LesKaribous/Karibous-2026-PAMI-Ninja/README.md

# Karibous-2026-PAMI-Ninja
PAMI Ninja - Coupe de France de robotique 2026
