LesKaribous/Karibous-2026-PAMI-Ninja/DESIGN/path2.png

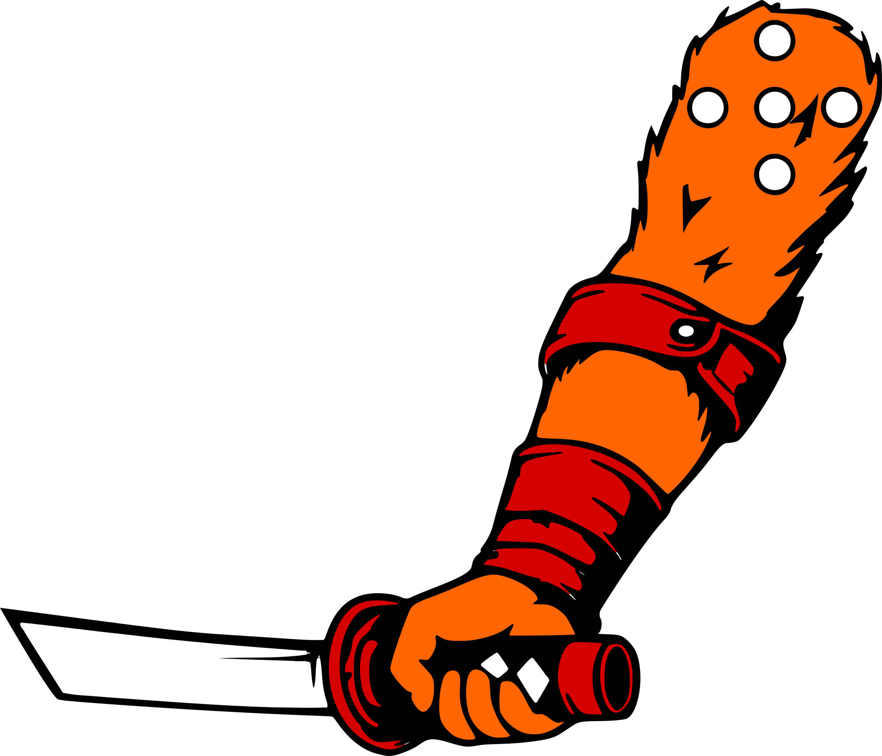
DESIGN/path2.png
