LesKaribous/Karibous-2026-PAMI-Ninja/MCAD/Import/pump-assembled.FCStd

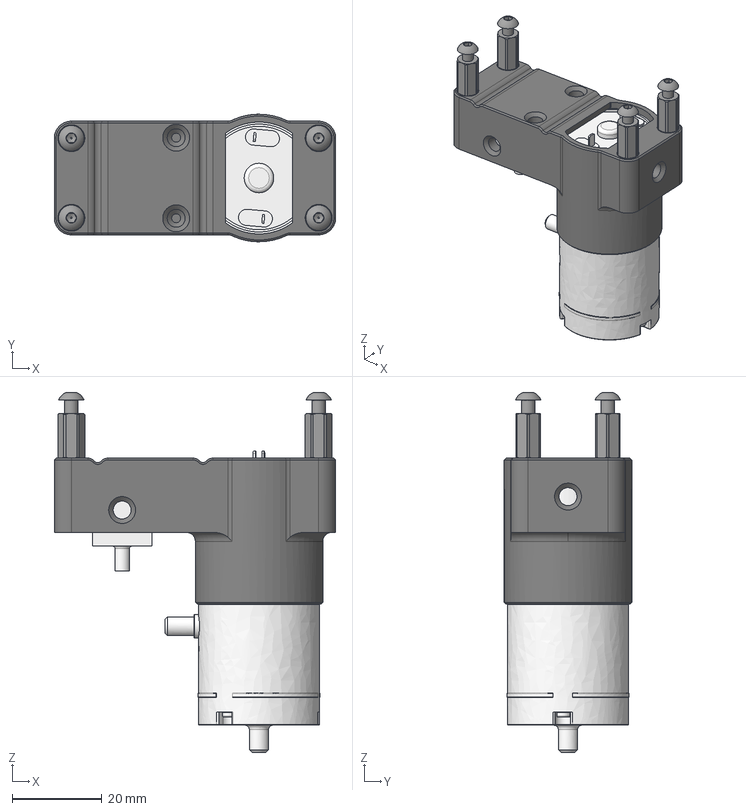
[picture p2: CAD file, 2026-01-25]
MCAD/Import/pump-assembled.FCStd
62.9 x 28.5 x 80.4 mm
SupportPompe x 2
M3x5.5x10-Spacer005
M3x5.5x10-Spacer006
M3x5.5x10-Spacer001
M3x5.5x10-Spacer
M3x6-Screw010
M3x6-Screw009
M3x6-Screw008
M3x6-Screw
