LesKaribous/Karibous-2026-PAMI-Ninja/DESIGN/arm-ninja-solo.3mf

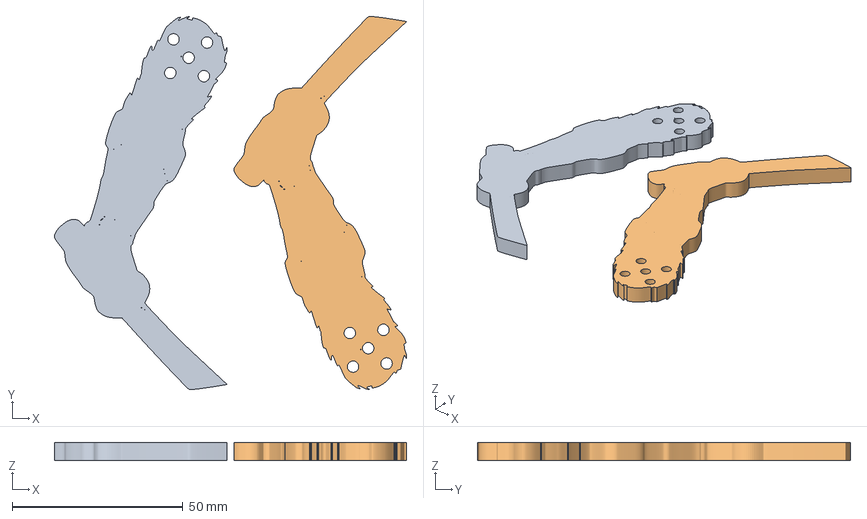
[picture p3: CAD file, 2026-03-20]
DESIGN/arm-ninja-solo.3mf
103.3 x 109.3 x 5.41 mm
Assembly x 2
