LesKaribous/Karibous-2026-PAMI-Ninja/ECAD/PumpBoard-2026/models/MICRO-POMPE 370 v2.step

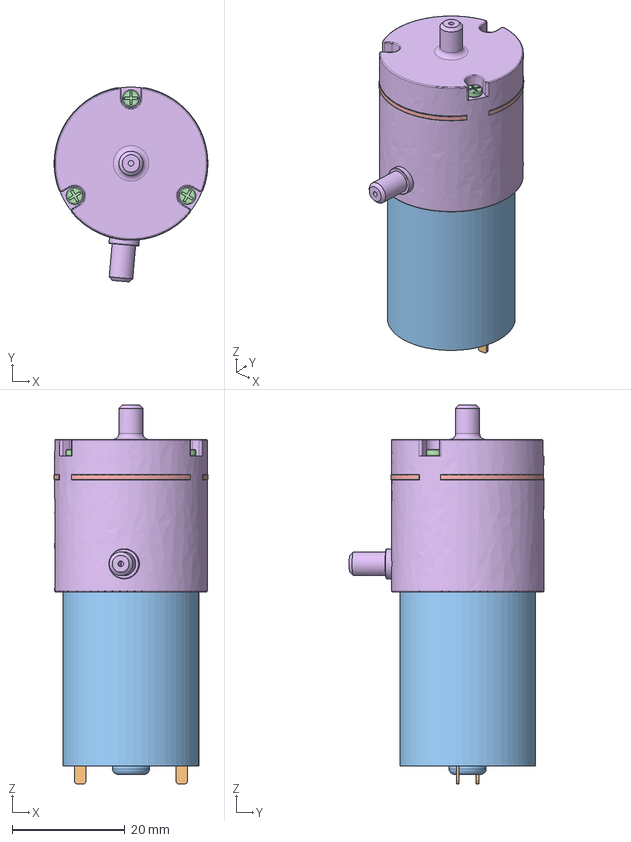
[picture p4: CAD file, 2026-01-25]
ECAD/PumpBoard-2026/models/MICRO-POMPE 370 v2.step
27.3 x 34.6 x 67.3 mm
