LesKaribous/Karibous-2026-PAMI-Ninja/ECAD/PumpBoard-2026/PumpBoard-2026.step

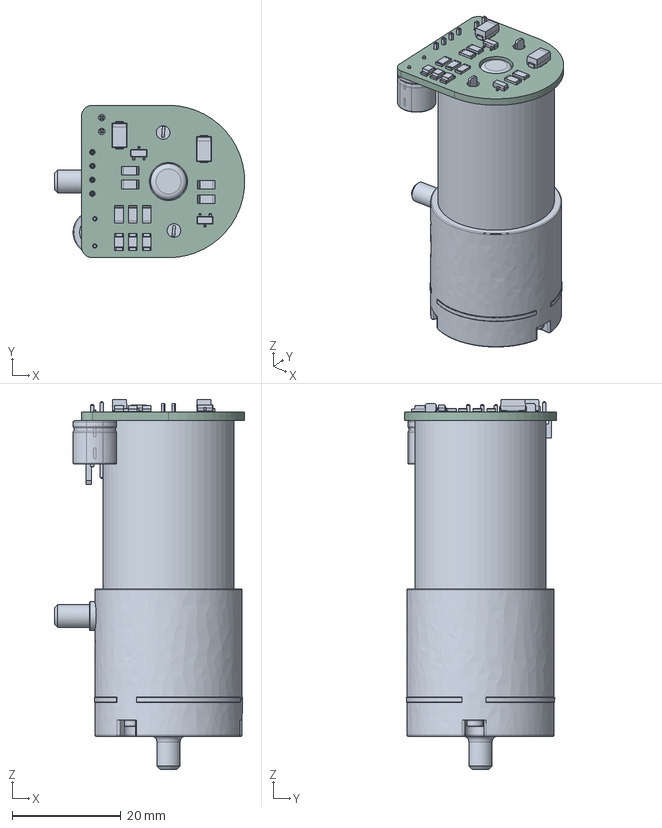
[picture p5: CAD file, 2026-01-25]
ECAD/PumpBoard-2026/PumpBoard-2026.step
35.0 x 28.0 x 68.0 mm
R_1206_3216Metric x 7
D_SMA x 2
LED_1206_3216Metric x 3
SOT-23 x 2
CP_Radial_D8.0mm_P5.00mm
MICRO-POMPE 370 v2
Molex_KK-254_AE-6410-02A_1x02_P2.54mm_Vertical
PinHeader_1x04_P2.54mm_Vertical
PumpBoard-2026_PCB
