LesKaribous/Karibous-2026-PAMI-Ninja/MCAD/Import/BAU.step

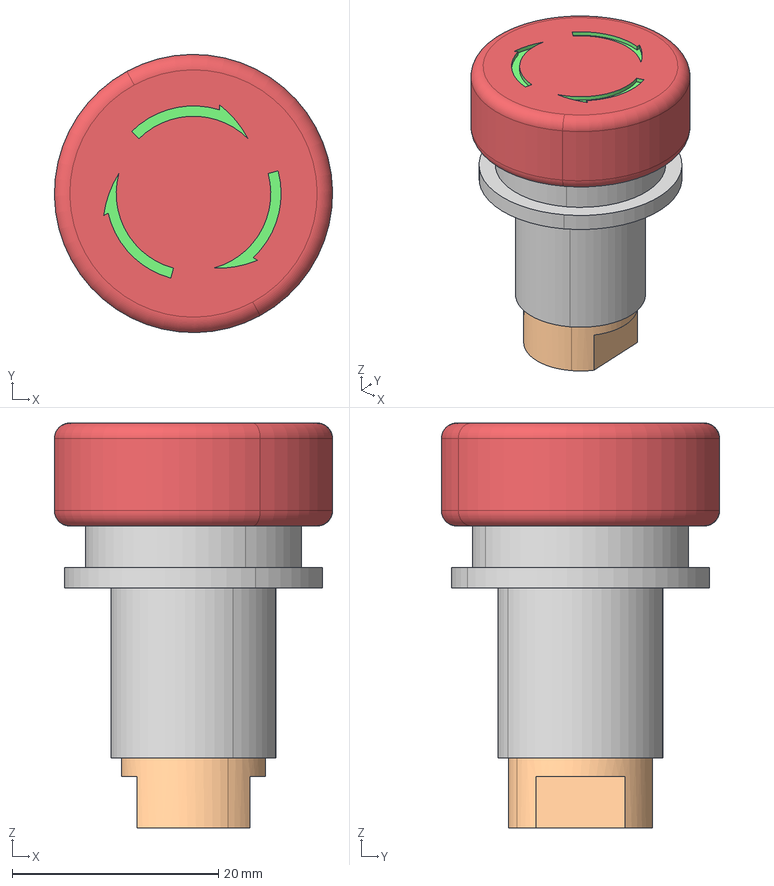
[picture p6: CAD file, 2026-01-25]
MCAD/Import/BAU.step
27.0 x 27.0 x 39.3 mm
