LesKaribous/Karibous-2026-PAMI-Ninja/MCAD/ProtoNINJA-Components.step

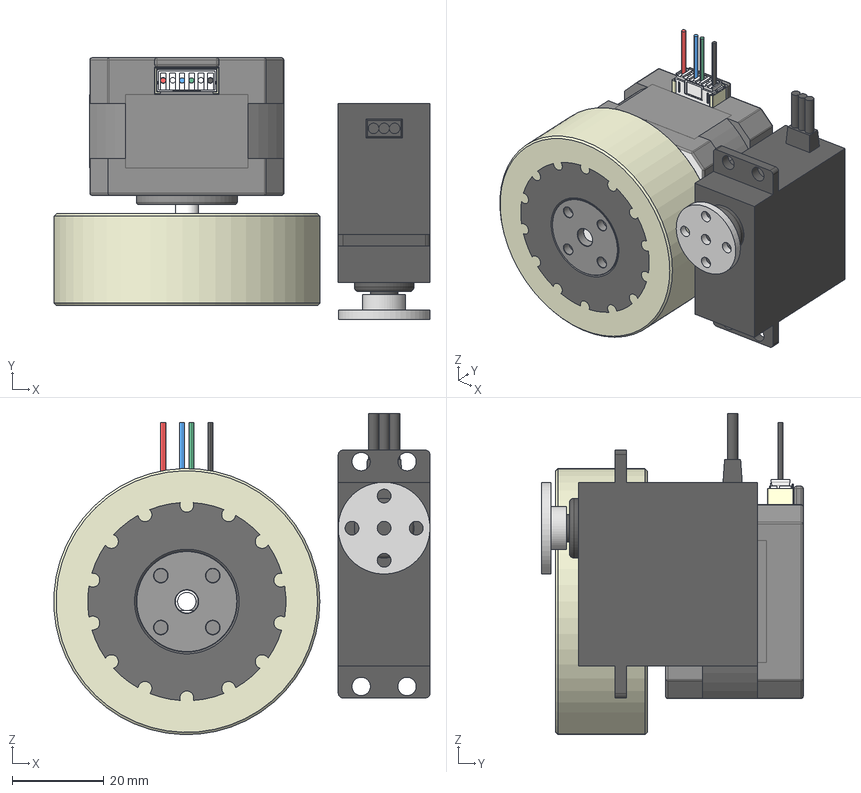
[picture p7: CAD file, 2026-05-08]
MCAD/ProtoNINJA-Components.step
81.9 x 57.0 x 70.0 mm
ServoBody001
ServoAxis001
RoundServoHorn001
Tire
Hub-ID-5mm-OD-22mm
CoreWheel0
17HE12-1204S
