LesKaribous/Karibous-2026-PAMI-Ninja/ECAD/PumpBoard-2026/models/miniEV.step

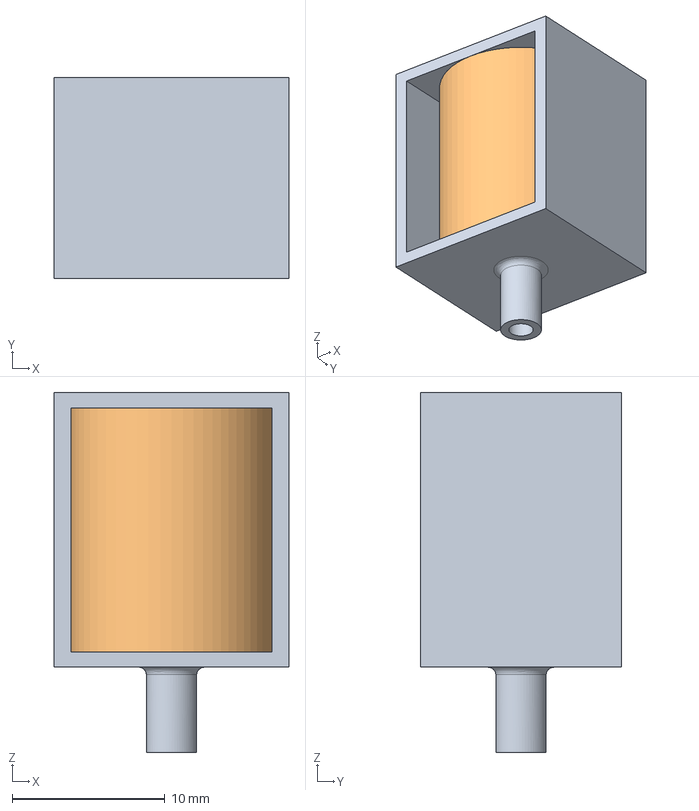
[picture p8: CAD file, 2026-01-25]
ECAD/PumpBoard-2026/models/miniEV.step
15.4 x 13.2 x 23.6 mm
