LesKaribous/Karibous-2026-PAMI-Ninja/MCAD/Import/CanonLPE6-Canon.step

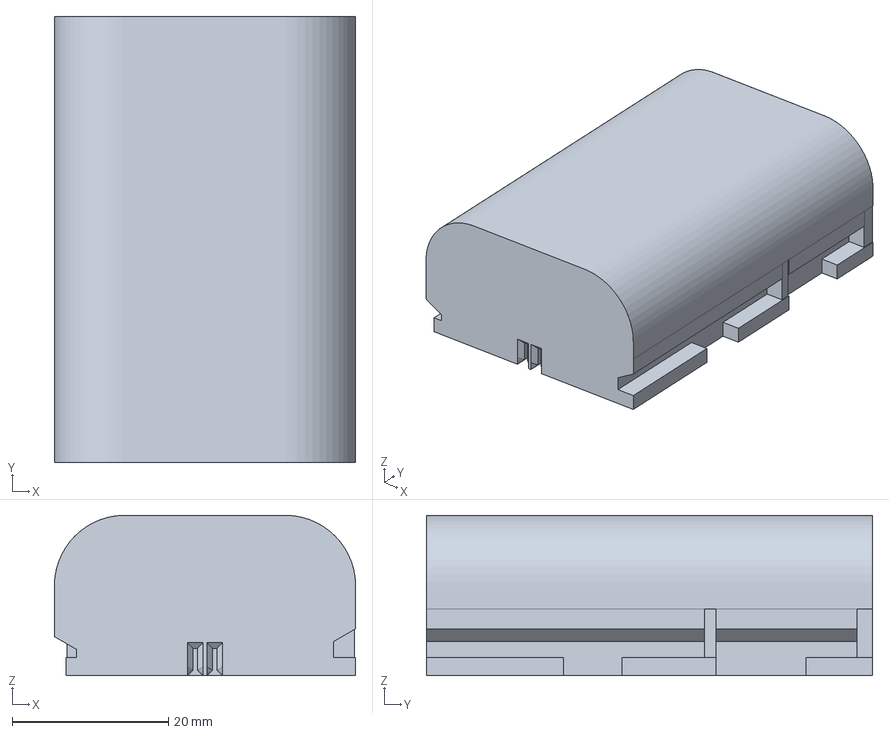
[picture p9: CAD file, 2026-01-25]
MCAD/Import/CanonLPE6-Canon.step
38.5 x 57.0 x 20.5 mm
