LesKaribous/Karibous-2026-PAMI-Ninja/MCAD/PAMI_NINJA.FCStd

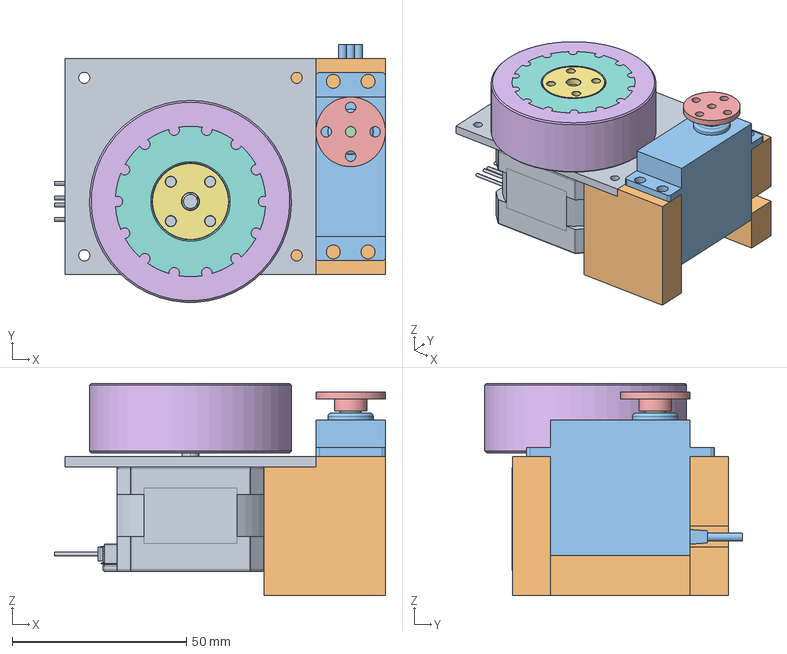
[picture p10: CAD file, 2026-05-08]
MCAD/PAMI_NINJA.FCStd
95.1 x 73.9 x 61.0 mm
Motor_Plate
Chassis
ServoBody001
ServoAxis001
RoundServoHorn001
Tire
Hub-ID-5mm-OD-22mm
CoreWheel0
17HE12-1204S
