LesKaribous/Karibous-2026-PAMI-Ninja/MCAD/PAMI_NINJA_DUMB_PUSHER.FCStd

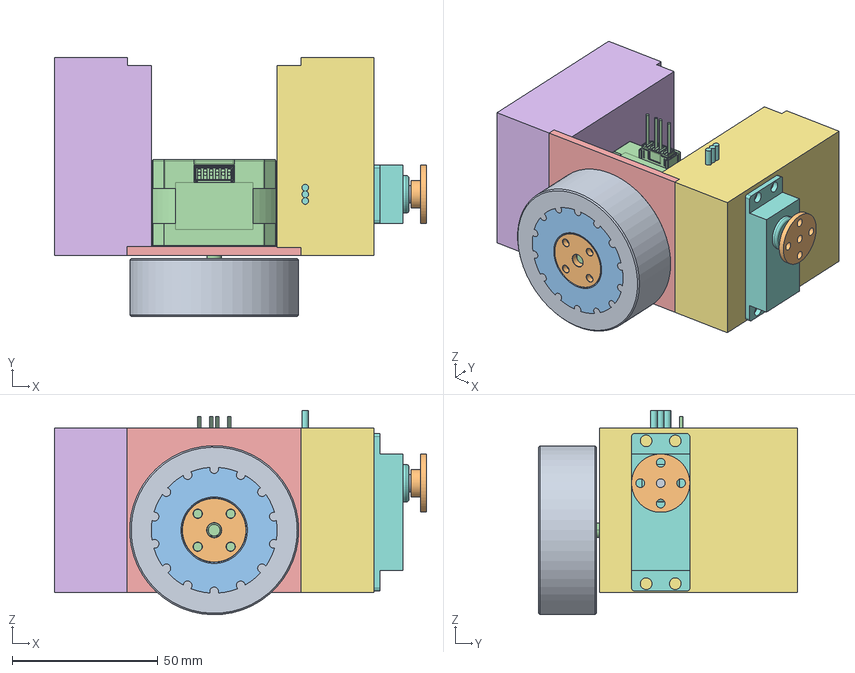
[picture p11: CAD file, 2026-05-08]
MCAD/PAMI_NINJA_DUMB_PUSHER.FCStd
127.7 x 89.0 x 70.1 mm
Tire
Hub-ID-5mm-OD-22mm
CoreWheel0
17HE12-1204S
MotorPlate
Chassis
ServoBody001
ServoAxis001
RoundServoHorn001
