LesKaribous/Karibous-2026-PAMI-Ninja/MCAD/Import/GENERIC-370_vaccum-pump-12V-4Lmin.STEP

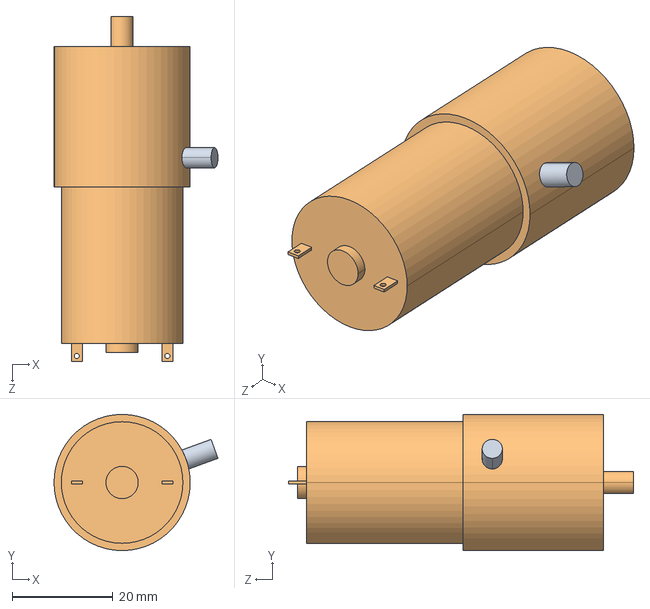
[picture p12: CAD file, 2026-01-25]
MCAD/Import/GENERIC-370_vaccum-pump-12V-4Lmin.STEP
32.5 x 27.0 x 68.4 mm
