LesKaribous/Karibous-2026-PAMI-Ninja/MCAD/ProtoNINJA.FCStd

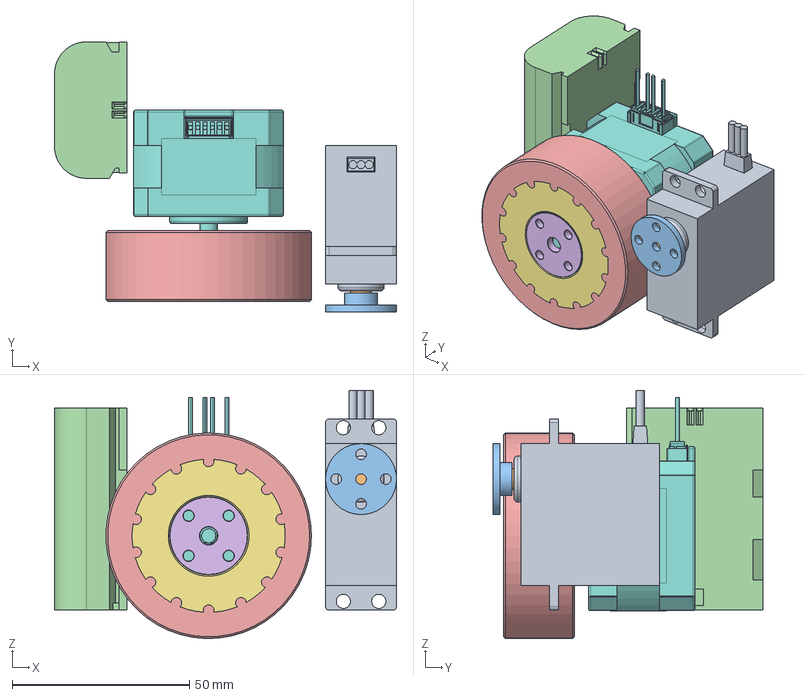
[picture p13: CAD file, 2026-05-08]
MCAD/ProtoNINJA.FCStd
96.5 x 76.2 x 70.0 mm
ServoBody001
ServoAxis001
RoundServoHorn001
CanonLPE6-Canon
Tire
Hub-ID-5mm-OD-22mm
CoreWheel0
17HE12-1204S
