LesKaribous/Karibous-2026-PAMI-Ninja/MCAD/Import/Gh-S37D Servo.STEP

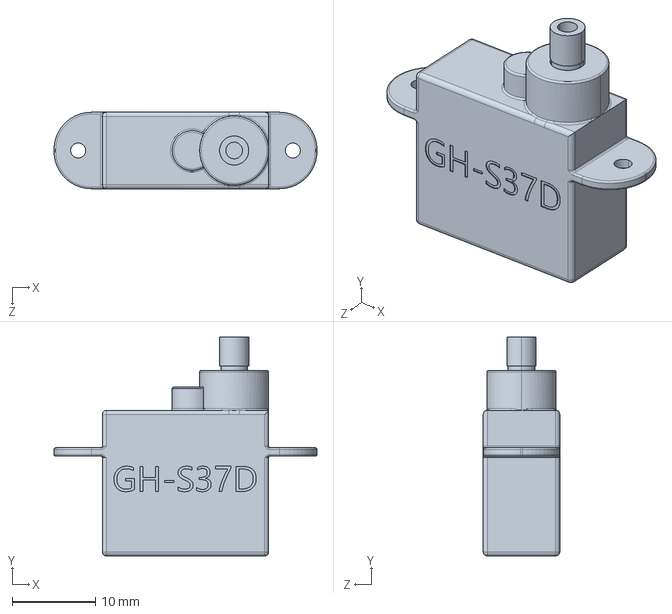
[picture p14: CAD file, 2026-01-25]
MCAD/Import/Gh-S37D Servo.STEP
31.6 x 26.3 x 9.20 mm
