LesKaribous/Karibous-2026-PAMI-Ninja/MCAD/Import/28BYJ-48_Stepper.STEP

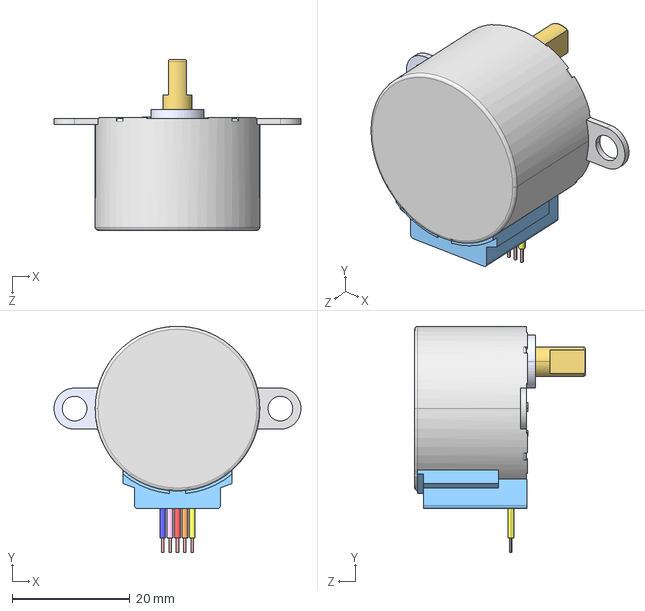
[picture p15: CAD file, 2026-01-25]
MCAD/Import/28BYJ-48_Stepper.STEP
42.0 x 38.5 x 29.0 mm
