LesKaribous/Karibous-2026-PAMI-Ninja/MCAD/Import/17HE12-1204S.STEP

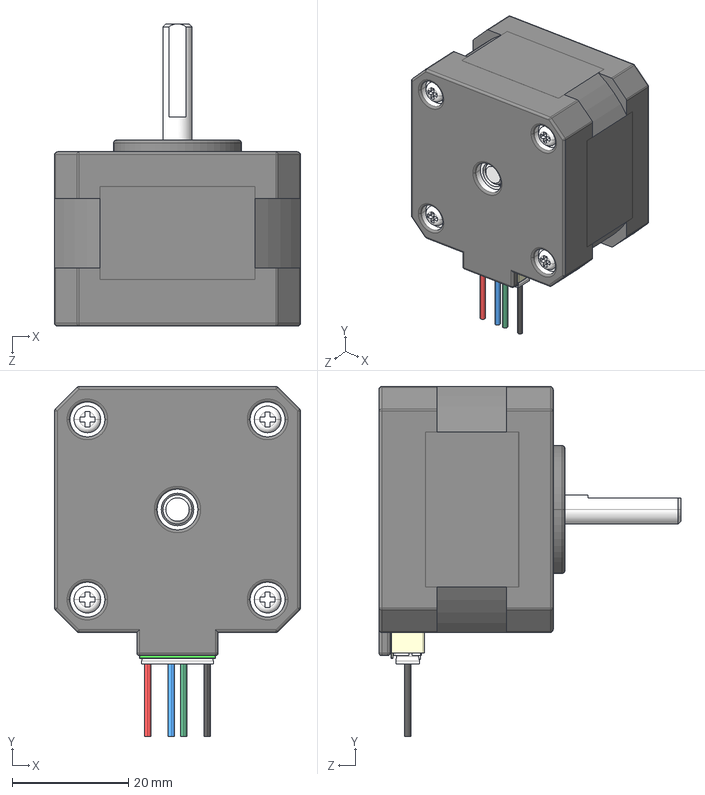
[picture p16: CAD file, 2026-01-25]
MCAD/Import/17HE12-1204S.STEP
42.3 x 60.2 x 52.0 mm
