LesKaribous/Karibous-2026-PAMI-Ninja/MCAD/Import/17HE15-1504S.STEP

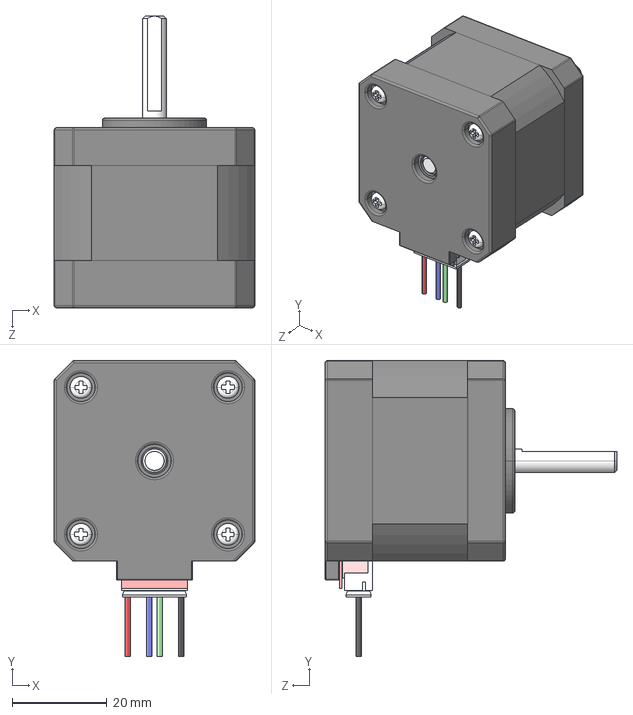
[picture p17: CAD file, 2026-01-25]
MCAD/Import/17HE15-1504S.STEP
42.3 x 62.4 x 61.5 mm
