LesKaribous/Karibous-2026-PAMI-Ninja/(list of files, cad)

Other CAD files:
ECAD/PumpBoard-2026/PumpBoard-2026.FCStd
