LesKaribous/Karibous-2026-PAMI-Ninja/ECAD/NinjaPAMI-2026/NinjaPAMI-2026.kicad_pcb

## KiCad design ECAD/NinjaPAMI-2026/NinjaPAMI-2026.kicad_pcb (2026-03-20)

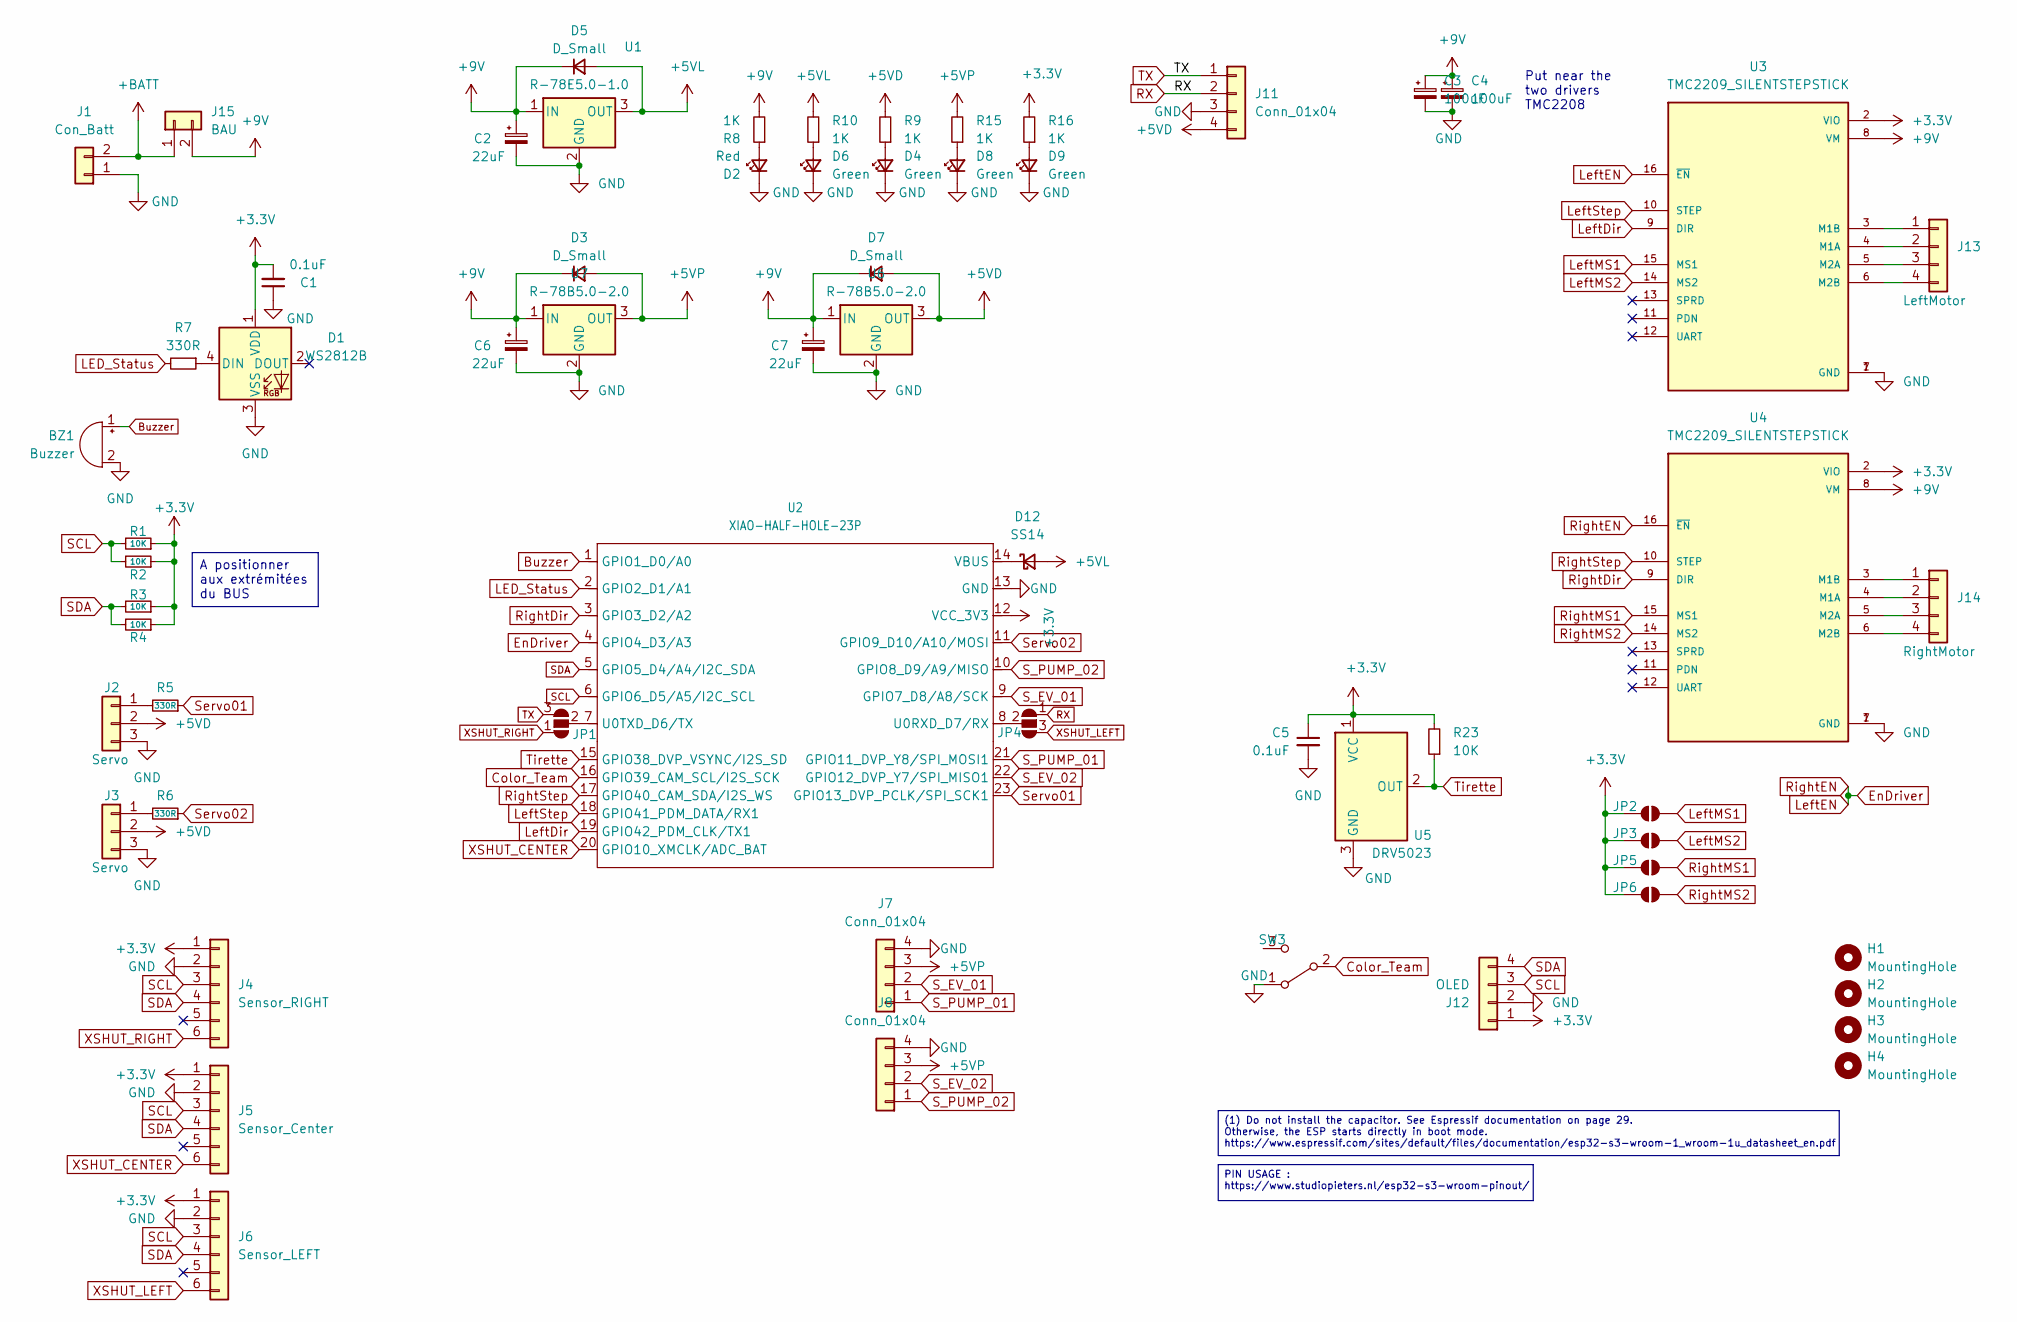
[picture p18: schematic NinjaPAMI-2026.kicad_sch]

Parts:
BZ1: Buzzer; Buzzer_12x9.5RM7.6
C1: 0.1uF; C_1206_3216Metric
C2, C6, C7: 22uF; CP_Elec_5x5.4
C3, C4: 100uF; CP_Radial_D8.0mm_P3.50mm
C5: 0.1uF; C_1206_3216Metric_Pad1.33x1.80mm_HandSolder
D1: WS2812B; LED_WS2812B_PLCC4_5.0x5.0mm_P3.2mm
D2: Red; LED_1206_3216Metric
D3, D5, D7: D_Small; D_SMA_Handsoldering
D4, D6, D8, D9: Green; LED_1206_3216Metric
D12: SS14; D_SMA_Handsoldering
H1, H2, H3, H4: MountingHole; MountingHole_3.2mm_M3
J1: Con_Batt; Molex_KK-254_AE-6410-02A_1x02_P2.54mm_Vertical
J2, J3: Servo; PinHeader_1x03_P2.54mm_Vertical
J4: Sensor_RIGHT; Molex_KK-254_AE-6410-06A_1x06_P2.54mm_Vertical
J5: Sensor_Center; Molex_KK-254_AE-6410-06A_1x06_P2.54mm_Vertical
J6: Sensor_LEFT; Molex_KK-254_AE-6410-06A_1x06_P2.54mm_Vertical
J7, J8, J11: Conn_01x04; Molex_KK-254_AE-6410-04A_1x04_P2.54mm_Vertical
J12: OLED; Molex_KK-254_AE-6410-04A_1x04_P2.54mm_Vertical
J13: LeftMotor; Molex_KK-254_AE-6410-04A_1x04_P2.54mm_Vertical
J14: RightMotor; Molex_KK-254_AE-6410-04A_1x04_P2.54mm_Vertical
J15: BAU; Molex_KK-254_AE-6410-02A_1x02_P2.54mm_Vertical
JP1, JP4: SolderJumper_3_Open; SolderJumper-3_P1.3mm_Open_RoundedPad1.0x1.5mm_NumberLabels
JP2, JP3, JP5, JP6: SolderJumper_2_Open; SolderJumper-2_P1.3mm_Open_RoundedPad1.0x1.5mm
R1, R2, R3, R4, R23: 10K; R_1206_3216Metric_Pad1.30x1.75mm_HandSolder
R5, R6, R7: 330R; R_1206_3216Metric_Pad1.30x1.75mm_HandSolder
R8, R9, R10, R15, R16: 1K; R_1206_3216Metric_Pad1.30x1.75mm_HandSolder
SW3: SW_SPDT; SK-12D10 1P2T
U1: R-78E5.0-1.0; Converter_DCDC_RECOM_R-78E-0.5_THT
U2: XIAO-HALF-HOLE-23P; MOUDLE23P-SMD-2.54-21X17.8MM.kicad_mod.kicad_sym
U3, U4: TMC2209_SILENTSTEPSTICK; MODULE_TMC2209_SILENTSTEPSTICK; PARTREV 1.20
U5: DRV5023; SOT-23_Handsoldering
U6, U7: R-78B5.0-2.0; Converter_DCDC_RECOM_R-78B-2.0_THT

Connections:
+3.3V: C1.2, C5.1, D1.1 (VDD), J4.1, J5.1, J6.1, J12.1, JP2.1 (A), JP3.1 (A), JP5.1 (A), JP6.1 (A), R1.1, R2.1, R3.1, R4.1, R16.2, R23.2, U2.12 (VCC_3V3), U3.2 (VIO), U4.2 (VIO), U5.1 (VCC)
+5VD: D7.2 (A), J2.2, J3.2, J11.4, R9.2, U6.3 (OUT)
+5VL: D5.2 (A), D12.2 (A), R10.2, U1.3 (OUT)
+5VP: D3.2 (A), J7.3, J8.3, R15.2, U7.3 (OUT)
+9V: C2.1, C3.1, C4.1, C6.1, C7.1, D3.1 (K), D5.1 (K), D7.1 (K), J15.2, R8.2, U1.1 (IN), U3.8 (VM), U4.8 (VM), U6.1 (IN), U7.1 (IN)
+BATT: J1.2, J15.1
Buzzer: BZ1.1 (+), U2.1 (GPIO1_D0/A0)
Color_Team: SW3.2 (B), U2.16 (GPIO39_CAM_SCL/I2S_SCK)
EnDriver: U2.4 (GPIO4_D3/A3), U3.16 (~EN), U4.16 (~EN)
GND: BZ1.2 (-), C1.1, C2.2, C3.2, C4.2, C5.2, C6.2, C7.2, D1.3 (VSS), D2.1 (K), D4.1 (K), D6.1 (K), D8.1 (K), D9.1 (K), J1.1, J2.3, J3.3, J4.2, J5.2, J6.2, J7.4, J8.4, J11.3, J12.2, SW3.1 (A), U1.2 (GND), U2.13 (GND), U3.1 (GND), U3.7 (GND), U4.1 (GND), U4.7 (GND), U5.3 (GND), U6.2 (GND), U7.2 (GND)
LED_Status: R7.2, U2.2 (GPIO2_D1/A1)
LeftDir: U2.19 (GPIO42_PDM_CLK/TX1), U3.9 (DIR)
LeftMS1: JP2.2 (B), U3.15 (MS1)
LeftMS2: JP3.2 (B), U3.14 (MS2)
LeftStep: U2.18 (GPIO41_PDM_DATA/RX1), U3.10 (STEP)
unnamed: D1.4 (DIN), R7.1
unnamed: D2.2 (A), R8.1
unnamed: D4.2 (A), R9.1
unnamed: D6.2 (A), R10.1
unnamed: D8.2 (A), R15.1
unnamed: D9.2 (A), R16.1
unnamed: D12.1 (K), U2.14 (VBUS)
unnamed: J2.1, R5.2
unnamed: J3.1, R6.2
unnamed: J13.1, U3.3 (M1B)
unnamed: J13.2, U3.4 (M1A)
unnamed: J13.3, U3.5 (M2A)
unnamed: J13.4, U3.6 (M2B)
unnamed: J14.1, U4.3 (M1B)
unnamed: J14.2, U4.4 (M1A)
unnamed: J14.3, U4.5 (M2A)
unnamed: J14.4, U4.6 (M2B)
unnamed: JP1.2 (C), U2.7 (U0TXD_D6/TX)
unnamed: JP4.2 (C), U2.8 (U0RXD_D7/RX)
RX: J11.2, JP4.1 (A)
RightDir: U2.3 (GPIO3_D2/A2), U4.9 (DIR)
RightMS1: JP5.2 (B), U4.15 (MS1)
RightMS2: JP6.2 (B), U4.14 (MS2)
RightStep: U2.17 (GPIO40_CAM_SDA/I2S_WS), U4.10 (STEP)
SCL: J4.3, J5.3, J6.3, J12.3, R1.2, R2.2, U2.6 (GPIO6_D5/A5/I2C_SCL)
SDA: J4.4, J5.4, J6.4, J12.4, R3.2, R4.2, U2.5 (GPIO5_D4/A4/I2C_SDA)
S_EV_01: J7.2, U2.9 (GPIO7_D8/A8/SCK)
S_EV_02: J8.2, U2.22 (GPIO12_DVP_Y7/SPI_MISO1)
S_PUMP_01: J7.1, U2.21 (GPIO11_DVP_Y8/SPI_MOSI1)
S_PUMP_02: J8.1, U2.10 (GPIO8_D9/A9/MISO)
Servo01: R5.1, U2.23 (GPIO13_DVP_PCLK/SPI_SCK1)
Servo02: R6.1, U2.11 (GPIO9_D10/A10/MOSI)
TX: J11.1, JP1.3 (B)
Tirette: R23.1, U2.15 (GPIO38_DVP_VSYNC/I2S_SD), U5.2 (OUT)
XSHUT_CENTER: J5.6, U2.20 (GPIO10_XMCLK/ADC_BAT)
XSHUT_LEFT: J6.6, JP4.3 (B)
XSHUT_RIGHT: J4.6, JP1.1 (A)

Notes on the sheet:
Put near the two drivers TMC2208
PIN USAGE : https://www.studiopieters.nl/esp32-s3-wroom-pinout/
A positionner aux extrémitées du BUS
(1) Do not install the capacitor. See Espressif documentation on page 29. Otherwise, the ESP starts directly in boot mode. https://www.espressif.com/sites/default/files/documentation/esp32-s3-wroom-1_wroom-1u_datasheet_en.pdf

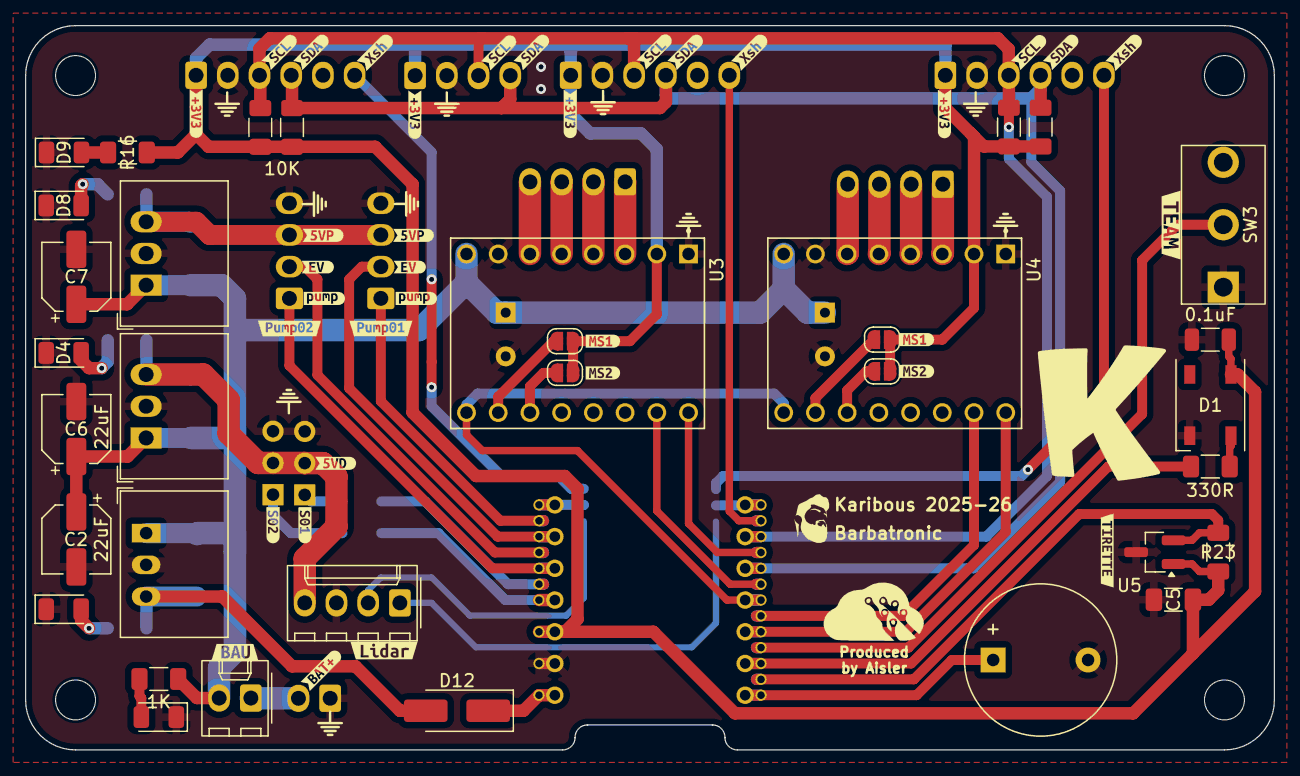
[picture p19: board NinjaPAMI-2026.kicad_pcb from above]

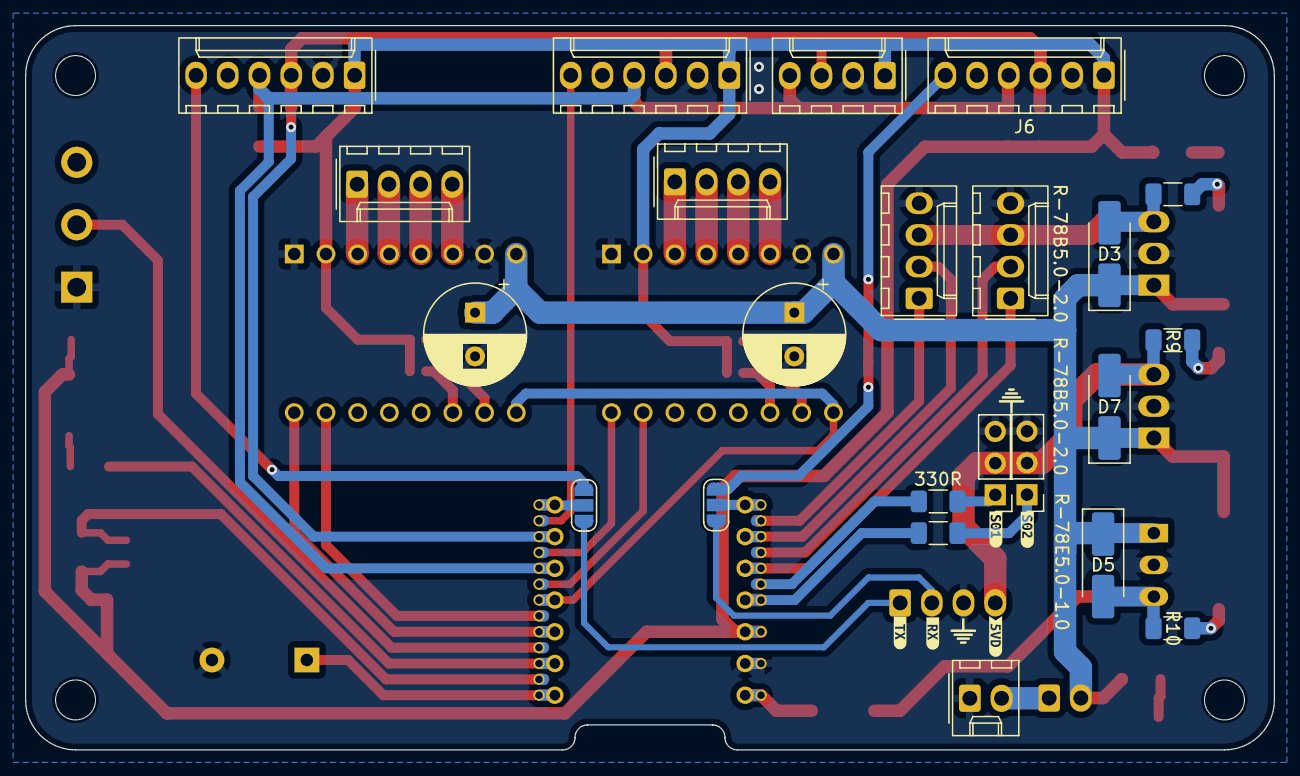
[picture p20: board NinjaPAMI-2026.kicad_pcb from below]

Board: 2 copper layers, 100.0 x 58.0 mm, 102 parts (28 on the bottom side), 52 nets.

Other parts of the board:
kibuzzard-670C04A5, kibuzzard-670C04A5#2, kibuzzard-670C04A5#3, kibuzzard-670C04A5#4: G***; kibuzzard-670C04A5
kibuzzard-670C07A3: G***; kibuzzard-670C07A3
kibuzzard-670C23C9: G***; kibuzzard-670C23C9
kibuzzard-670C047F: G***; kibuzzard-670C047F
kibuzzard-670C0507: G***; kibuzzard-670C0507
kibuzzard-670C0798: G***; kibuzzard-670C0798
kibuzzard-6998F5BE: G***; kibuzzard-6998F5BE
kibuzzard-6998F5D7: G***; kibuzzard-6998F5D7
kibuzzard-6998F8A6, kibuzzard-6998F8A6#2: G***; kibuzzard-6998F8A6
kibuzzard-6998F8DE: G***; kibuzzard-6998F8DE
kibuzzard-6998F8EA: G***; kibuzzard-6998F8EA
kibuzzard-6998F9AD, kibuzzard-6998F9AD#2: G***; kibuzzard-6998F9AD
kibuzzard-6998F92F, kibuzzard-6998F92F#2: G***; kibuzzard-6998F92F
kibuzzard-6998F94E, kibuzzard-6998F94E#2: G***; kibuzzard-6998F94E
kibuzzard-6998F900, kibuzzard-6998F900#2: G***; kibuzzard-6998F900
kibuzzard-6998F954, kibuzzard-6998F954#2: G***; kibuzzard-6998F954
kibuzzard-6998FA9D, kibuzzard-6998FA9D#2, kibuzzard-6998FA9D#3, kibuzzard-6998FA9D#4: G***; kibuzzard-6998FA9D
kibuzzard-6998FAED, kibuzzard-6998FAED#2, kibuzzard-6998FAED#3, kibuzzard-6998FAED#4: G***; kibuzzard-6998FAED
kibuzzard-6998FB46, kibuzzard-6998FB46#2, kibuzzard-6998FB46#3: G***; kibuzzard-6998FB46
kibuzzard-6998FE5D, kibuzzard-6998FE5D#2: G***; kibuzzard-6998FE5D
kibuzzard-6998FE66, kibuzzard-6998FE66#2: G***; kibuzzard-6998FE66
