LesKaribous/Karibous-2026-PAMI-Ninja/ECAD/PumpBoard-2026/PumpBoard-2026.kicad_pcb

## KiCad design ECAD/PumpBoard-2026/PumpBoard-2026.kicad_pcb (2026-02-20)

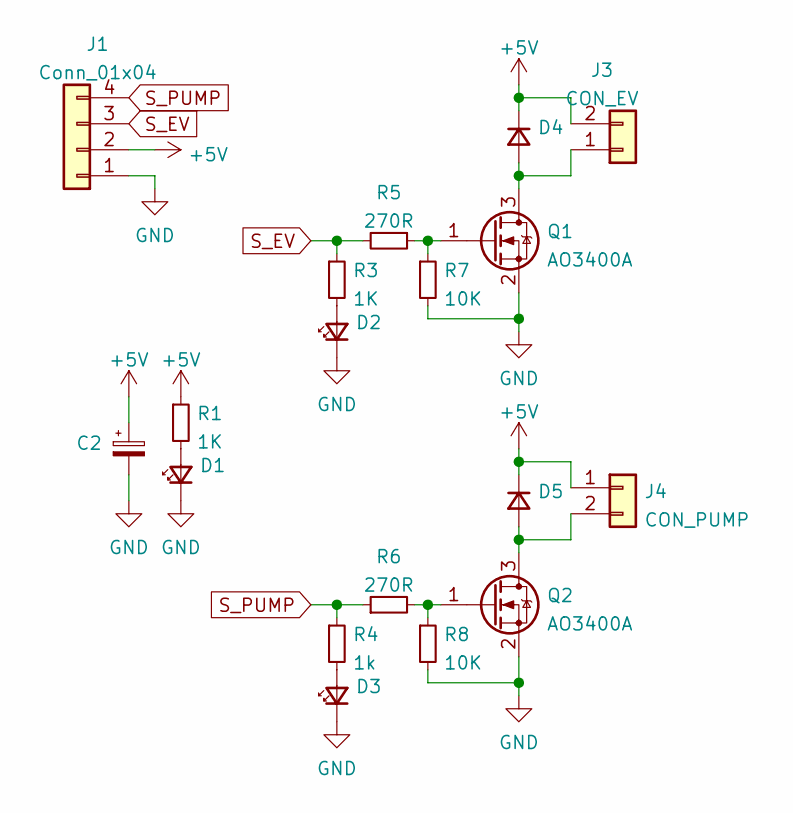
[picture p21: schematic PumpBoard-2026.kicad_sch]

Parts:
C2: C_Polarized_Small; CP_Radial_D8.0mm_P5.00mm
D1, D2, D3: LED_Small; LED_1206_3216Metric_Pad1.42x1.75mm_HandSolder
D4, D5: D_Small; D_SMA_Handsoldering
J1: Conn_01x04; PinHeader_1x04_P2.54mm_Vertical
J3: CON_EV; Molex_KK-254_AE-6410-02A_1x02_P2.54mm_Vertical
J4: CON_PUMP; motor-pump-370
Q1, Q2: AO3400A; SOT-23
R1, R3: 1K; R_1206_3216Metric_Pad1.30x1.75mm_HandSolder
R4: 1k; R_1206_3216Metric_Pad1.30x1.75mm_HandSolder
R5, R6: 270R; R_1206_3216Metric_Pad1.30x1.75mm_HandSolder
R7, R8: 10K; R_1206_3216Metric_Pad1.30x1.75mm_HandSolder

Connections:
+5V: C2.1, D4.1 (K), D5.1 (K), J1.2, J3.2, J4.1, R1.1
GND: C2.2, D1.1 (K), D2.1 (K), D3.1 (K), J1.1, Q1.2 (S), Q2.2 (S), R7.2, R8.2
unnamed: D1.2 (A), R1.2
unnamed: D2.2 (A), R3.2
unnamed: D3.2 (A), R4.2
unnamed: D4.2 (A), J3.1, Q1.3 (D)
unnamed: D5.2 (A), J4.2, Q2.3 (D)
unnamed: Q1.1 (G), R5.1, R7.1
unnamed: Q2.1 (G), R6.2, R8.1
S_EV: J1.3, R3.1, R5.2
S_PUMP: J1.4, R4.1, R6.1

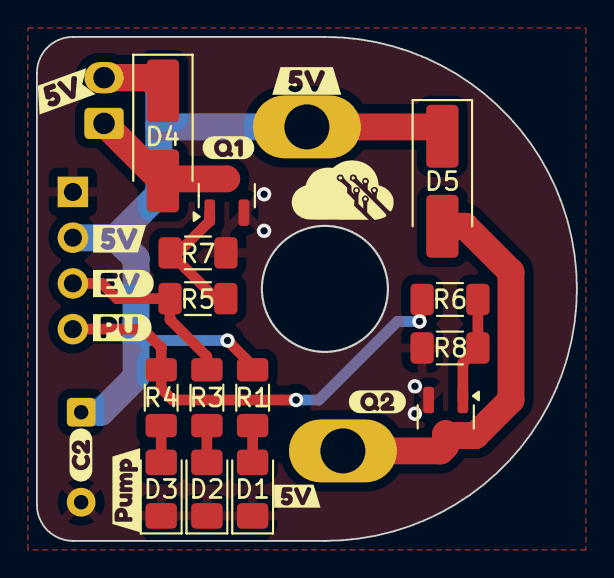
[picture p22: board PumpBoard-2026.kicad_pcb from above]

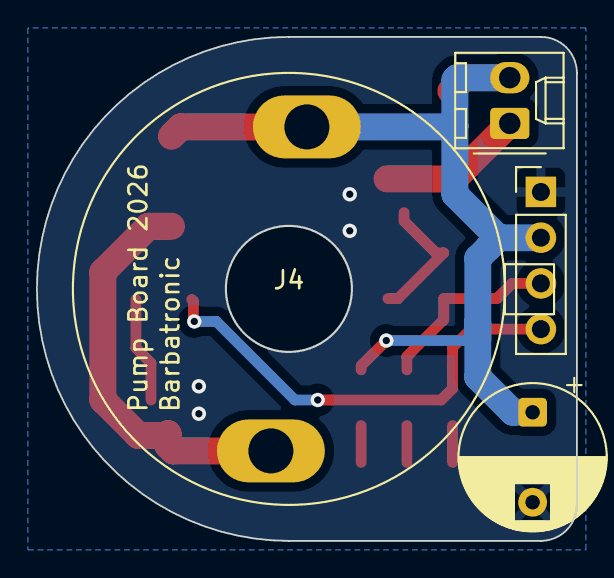
[picture p23: board PumpBoard-2026.kicad_pcb from below]

Board: 2 copper layers, 30.0 x 28.0 mm, 28 parts (4 on the bottom side), 11 nets.

Other parts of the board:
kibuzzard-697692E7: G***; kibuzzard-697692E7
kibuzzard-697693AB: G***; kibuzzard-697693AB
kibuzzard-697693BC: G***; kibuzzard-697693BC
kibuzzard-6976928C: G***; kibuzzard-6976928C
kibuzzard-6976930F: G***; kibuzzard-6976930F
kibuzzard-6976945E: G***; kibuzzard-6976945E
kibuzzard-6976947C: G***; kibuzzard-6976947C
kibuzzard-69769280: G***; kibuzzard-69769280
kibuzzard-69769299: G***; kibuzzard-69769299
kibuzzard-69769485: G***; kibuzzard-69769485
