LesKaribous/Karibous-2026-PAMI-Ninja/FIRMWARE/Firmware-PAMI-NINJA-2026/src/match.h

// match.h
#ifndef MATCH_H
#define MATCH_H

#include <Arduino.h>
#include "ihm.h"

#define TIME_START_MATCH 1000  // TODO 85000
#define TIME_END_MATCH 100000   //100000

#define MATCH_WAIT 0
#define MATCH_BEGIN 1
#define PAMI_RUN 2
#define PAMI_STOP 3

int getMatchState();
void setMatchState(int _state);
void startMatch();
void updateMatchTime();
long getElapsedTime();
long getStartTime();
void pause(long millisecondes);

#endif // MATCH_H
