LesKaribous/Karibous-2026-PAMI-Ninja/(commit log)

2026-01-25 Transfer files from old repo
    [17HE12-1204S.STEP, 17HE15-1504S.STEP, 28BYJ-48_Stepper.STEP, BAU.step, CanonLPE6-Canon.step, GENERIC-370_vaccum-pump-12V-4Lmin.STEP, Gh-S37D Servo.STEP, NinjaPAMI-2026.kicad_pcb]
2026-01-25 placement pump and ev
    [NinjaPAMI-2026.kicad_pcb, NinjaPAMI-2026.kicad_sch]
2026-01-25 routage carte pompe
    [MICRO-POMPE 370 v2.step, PumpBoard-2026.kicad_pcb, PumpBoard-2026.kicad_sch, PumpBoard-2026.step, miniEV.step]
2026-01-25 modify ARU
    [NinjaPAMI-2026.kicad_pcb, NinjaPAMI-2026.kicad_sch]
2026-01-25 add hall effect sensor
    [NinjaPAMI-2026.kicad_pcb, NinjaPAMI-2026.kicad_sch]
2026-02-20 size refactor - add 2.0 regulator
    [NinjaPAMI-2026.kicad_pcb, NinjaPAMI-2026.kicad_sch]
2026-02-20 ready to order
    [PumpBoard-2026.kicad_pcb]
2026-02-21 routing and silkscreen
    [NinjaPAMI-2026.kicad_pcb, NinjaPAMI-2026.kicad_sch]
2026-03-05 Create .kicad-push
2026-03-20 ninja arm
    [arm-ninja-solo.3mf]
2026-03-20 fix driver inverted issue
    [NinjaPAMI-2026-B_Mask.gbr, NinjaPAMI-2026-B_Paste.gbr, NinjaPAMI-2026-B_Silkscreen.gbr, NinjaPAMI-2026-Back.gbr, NinjaPAMI-2026-Edge_Cuts.gbr, NinjaPAMI-2026-F_Mask.gbr, NinjaPAMI-2026-F_Paste.gbr, NinjaPAMI-2026-F_Silkscreen.gbr]
2026-04-08 invert actuators
2026-04-08 trim actuators
2026-04-08 trim motion and motors
2026-04-09 Add third sensor to check
2026-04-09 new: multitasking sensor reading
2026-04-09 feat: opponent direction and filtering
2026-05-08 Modified strategy
    [PAMI_NINJA.FCStd, PAMI_NINJA_DUMB_PUSHER.FCStd, ProtoNINJA-Components.step, ProtoNINJA.FCStd]
2026-05-14 Added clearance and init datum to strat
    [main.cpp, motion.h]
